mwfigueroa/Electronic_Billboard/foto/panel_p5.png

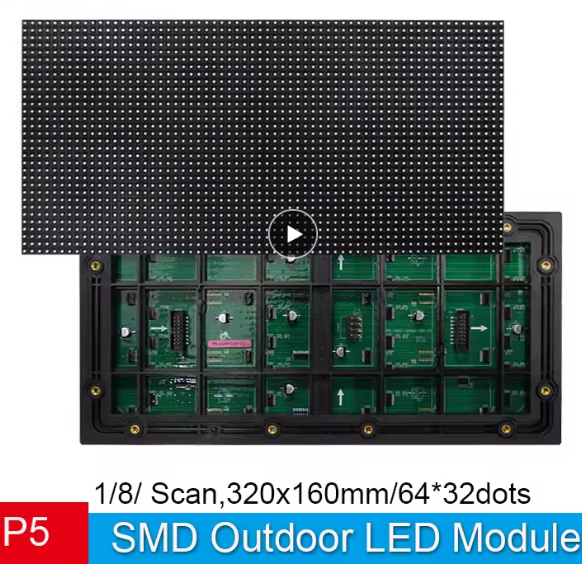
foto/panel_p5.png
