mwfigueroa/Electronic_Billboard/simulator/examples/escena.png

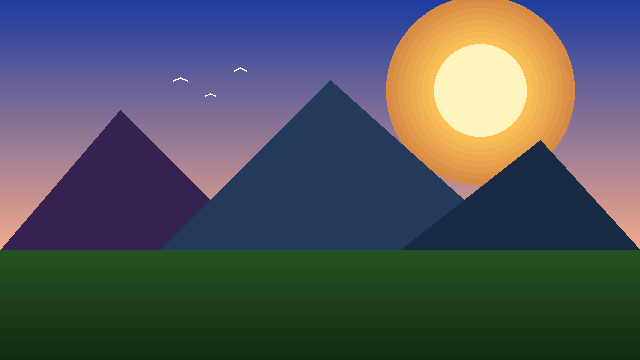
simulator/examples/escena.png
