mwfigueroa/Electronic_Billboard/docs/11_arquitectura_colorlight_5a75b.md

# 11 — Arquitectura del driver sobre Colorlight 5A-75B

Plataforma adoptada en [`10_plataforma_driver.md`](10_plataforma_driver.md). Este documento define la arquitectura del sistema, el punto de operación y el plan de bring-up del driver propio.

> **No sobrescribir el flash de configuración sin respaldo previo.** La 5A-75B arranca desde su SPI flash con el bitstream de fábrica. Volcar esa imagen completa antes de escribir nada.

## La placa

Datos de la **revisión 8.0**, que es la que se compra. Los componentes cambian entre revisiones — ver [`12_referencias_tecnicas.md`](12_referencias_tecnicas.md) para la tabla completa.

| Elemento | Detalle |
|---|---|
| FPGA | Lattice ECP5 **LFE5U-25F-6BG256C**, 24.300 LUT, **1.008 Kbit** de BRAM (EBR) |
| Salidas | **8 conectores HUB75**, 56 salidas bufferadas por 12× 74HC245T a 5 V |
| Memoria externa | SDRAM ESMT **M12L64322A**, 2M × 32 bit, 200 MHz = **8 MB** |
| Red | 2× PHY Gigabit Ethernet Realtek **RTL8211FD** |
| Configuración | SPI flash Winbond **25Q32JVSIQ**, 32 Mbit = 4 MB |
| Reloj | 25 MHz generado por el PHY y distribuido al pin **P6** del FPGA |
| Costo | USD 15–20 |

### Revisión a comprar

La placa tiene variantes con **pinouts y componentes distintos**: 6.1, 7.0, 8.0 y 8.2. No es un detalle menor — cambian el encapsulado del FPGA, la SDRAM, el PHY y todo el mapeo de pines a los conectores HUB75.

**Comprar revisión 8.0 u 8.2.** Son las que `litex-boards` soporta con LiteDRAM, lo que habilita usar la memoria externa sin escribir un controlador propio, y las que tienen el pinout mejor documentado. La 6.1 además usa encapsulado CABGA381 en vez de CABGA256, así que ni siquiera comparte el archivo de restricciones.

Al recibir la placa, identificar la revisión serigrafiada y contrastarla contra [chubby75](https://github.com/q3k/chubby75/tree/master/5a-75b). El pinout completo de la 8.0 y la tabla de diferencias entre revisiones están en [`12_referencias_tecnicas.md`](12_referencias_tecnicas.md).

## Arquitectura del sistema

La 5A-75B es una **placa receptora**: no tiene WiFi, RTC ni almacenamiento de playlist. El sistema completo necesita una capa de contenido por encima.

```mermaid
flowchart TB
    subgraph Contenido["Capa de contenido"]
        CPU["SoC LiteX / VexRiscv<br/>dentro del ECP5<br/>playlist, horarios, NTP"]
        Flash["SPI flash 25Q32<br/>4 MB, bitstream + contenido"]
        Net["PHY Gigabit Ethernet<br/>LiteEth"]
    end

    subgraph FPGA["ECP5-25 — driver de panel"]
        FB["Framebuffer RGB<br/>SDRAM 8 MB"]
        Conv["Conversor RGB → bitplanes"]
        BP["Bitplanes<br/>BRAM interna"]
        Seq["Secuenciador BCM<br/>+ mapeo de scan 1/8"]
        Ser["8 × serializador HUB75"]
    end

    Ext["Router / AP WiFi<br/>o puente ESP32"] -->|"Ethernet"| Net
    Net --> CPU
    Flash --> CPU
    CPU --> FB
    FB --> Conv
    Conv --> BP
    BP --> Seq
    Seq --> Ser
    Ser -->|"J1 … J8"| Panel["16 módulos P5<br/>8 cadenas de 2<br/>256 × 128 px"]
```

### Enlace de contenido

Tres opciones, en orden de preferencia:

1. **SoC LiteX con VexRiscv dentro del propio ECP5** (recomendada). LiteX aporta el softcore RISC-V, LiteEth y LiteDRAM ya integrados para esta placa. La lógica de playlist, horarios y NTP corre en el FPGA; el contenido llega por Ethernet. No hace falta MCU externo. WiFi se resuelve con un AP o puente en el gabinete, que además sirve para mantenimiento.
2. **ESP32 externo por SPI.** Más simple conceptualmente, pero requiere pines libres accesibles en la placa — los buffers de los puertos HUB75 son unidireccionales de salida y no sirven como entrada. Hay que verificar puntos de test disponibles contra chubby75.
3. **ESP32 con MAC Ethernet** (ESP32 clásico con PHY RMII, o ESP32-P4) hablando con LiteEth. Útil si se quiere mantener el ecosistema ESP-IDF para el contenido.

Durante el bring-up **no se necesita ninguna de las tres**: los patrones de prueba se generan dentro del FPGA.

## Topología de paneles

Cambia respecto del diseño original con HD-WF4:

| | HD-WF4 | **5A-75B** |
|---|---|---|
| Cadenas | 4 de 4 módulos | **8 de 2 módulos** |
| Puertos usados | 4 de 4 | 8 de 8 |
| Cables flat | 16 | 16 (sin cambio) |
| Clocks por bitplane (datos) | 8.192 | **2.048** |

Cada fila física del cartel (4 módulos) se divide en **dos cadenas de 2 módulos**, alimentadas por dos puertos contiguos. El cableado de potencia 5 V no cambia: sigue siendo una fuente LRS-350-5 por fila con dos inyecciones de 12 AWG. Ver [`03_electrico.md`](03_electrico.md).

## Presupuesto de memoria

Los 1.008 Kbit de BRAM equivalen a **126 KB**. Un frame de 256 × 128 px ocupa:

| Profundidad | bits/px | Frame | BRAM neta | DP16KD (medido) | Doble buffer |
|---|---:|---:|---:|---:|---|
| 4 bits/color | 12 | 48 KB | 38 % | 24/56 = 43 % | 48 bloques — entra |
| **5 bits/color** | 15 | **60 KB** | **48 %** | **30/56 = 54 %** | 60 bloques — **no entra** |
| 6 bits/color | 18 | 72 KB | 57 % | 32/56 = 57 % | no entra |
| 8 bits/color | 24 | 96 KB | 76 % | 48/56 = 86 % | no entra |

La columna "neta" es la proporción de bits y sirve de cota; la **medida** sale de sintetizar [`driver-5a75b/bitplane_store`](../driver-5a75b/README.md) en el ECP5-25 y es la que manda, porque el primitivo DP16KD es de 18 bits de ancho: 4 y 5 bits por color se redondean al mismo ancho (12 y 15 bits no llenan los 18), 6 bits lo llenan exacto (por eso coincide con la neta) y 8 bits desperdicia un tercio de cada palabra de 36. Con 5 bits quedan 26 bloques libres: alcanza para el contenido, **no** para un segundo framebuffer.

**Diseño adoptado**: los bitplanes viven en BRAM (acceso determinista, sin latencia de SDRAM en el camino crítico del refresco) y los frames RGB más el contenido viven en la SDRAM de 8 MB. El conversor RGB → bitplanes corre solo cuando cambia el contenido, no en cada refresco.

Esto evita el problema que descartó al EP4CE6: el refresco lee de memoria local rápida, y el enlace de contenido solo mueve datos cuando hay un cambio de slide — **~12 KB/s promedio en vez de 12,3 MB/s sostenidos**.

## Punto de operación

Con 8 buses, 2.048 clocks de datos por bitplane. El secuenciador implementado ([`driver-5a75b/bcm_sequencer`](../driver-5a75b/README.md)) agrega 4 clocks de blanking por paso de dirección —necesarios para latchear y asentar la fila con las salidas apagadas—, así que el frame real usa 2.080 clocks por bitplane:

| Profundidad | 12,5 MHz | 16 MHz | 25 MHz |
|---|---:|---:|---:|
| 4 bits/color | 401 Hz | 513 Hz | 801 Hz |
| **5 bits/color** | **194 Hz** | **248 Hz** | 388 Hz |
| 6 bits/color | 95 Hz | 122 Hz | 191 Hz |

**Objetivo inicial: 5 bits/color a 12,5 MHz = 194 Hz** (193,9 Hz medidos en simulación). Cumple el criterio de ≥ 192 Hz con ~1 % de margen; el margen real está en el clock: a 16 MHz sube a 248 Hz. El clock de panel se sube a 16 o 25 MHz solo después de verificar con analizador lógico que no hay ghosting ni pérdida de integridad de señal en los cables flat.

Para cartelería exterior, 5 bits por color (32.768 colores) es suficiente. Subir a 6 bits queda al borde del criterio a 25 MHz (191 Hz con el blanking actual; con `BLANK_CLOCKS=2` llegaría a ~192 Hz), así que si el contenido lo justifica conviene validarlo en banco antes de fijarlo.

## Bloques HDL

| Bloque | Responsabilidad |
|---|---|
| `hub75_serializer` (×8) | Desplaza RGB, genera `CLK` por puerto. Idéntico ocho veces, instanciado en paralelo. |
| `bcm_sequencer` | Secuencia de bitplanes, ancho de pulso de `OE`, blanking de `LAT`, avance de dirección `A`/`B`/`C`. Uno solo: gobierna los ocho serializadores en lockstep. |
| `scan_mapper` | Traduce `(x, y)` del framebuffer a `(paso de dirección, posición en cadena, grupo)`. **Específico del panel — es la incógnita principal.** |
| `bitplane_store` | BRAM de bitplanes, doble puerto: escritura del conversor, lectura del secuenciador. |
| `rgb_to_bitplane` | Conversión de frame RGB a planos de bits, con corrección de gamma. Corre en cambios de contenido. |
| `LiteDRAM` | Controlador de SDRAM. Provisto por LiteX en revisiones 8.0/8.2. |
| `LiteEth` | MAC + UDP/Etherbone. Provisto por LiteX. |

Los ocho serializadores comparten direcciones, `LAT` y `OE` — igual que la HD-WF4 compartía esas señales entre bancos. La diferencia es que acá los ocho transmiten **simultáneamente**, no alternados, porque cada uno tiene sus propios pines RGB.

## Toolchain

Todo abierto, sin licencias:

| Herramienta | Función |
|---|---|
| **Yosys** | Síntesis Verilog |
| **nextpnr-ecp5** | Place & route |
| **Project Trellis** | Generación de bitstream |
| **openFPGALoader** | Carga por JTAG y escritura de la SPI flash |
| **LiteX** + `litex-boards` | SoC, LiteEth, LiteDRAM, plataforma `colorlight_5a_75b` |
| **Verilator** / **cocotb** | Simulación y testbench |

Recomendado: instalar vía [oss-cad-suite](https://github.com/YosysHQ/oss-cad-suite-build), que trae todo empaquetado. Sobre Windows funciona bien bajo WSL2.

## Plan de bring-up

### Paso 0 — Identificar y respaldar

- [ ] Fotografiar ambos lados, anotar revisión serigrafiada y contrastar con chubby75.
- [ ] Verificar que sea revisión 8.0 u 8.2; si no, ajustar el archivo de plataforma de LiteX al pinout real.
- [ ] Volcar la SPI flash completa (4 MB en rev 8.0) antes de escribir nada.
- [ ] Instalar oss-cad-suite y cargar un bitstream de blink por JTAG (sin tocar la flash) para validar el flujo.

### Paso 1 — Un módulo, un puerto, sin BCM

- [ ] Instanciar un solo `hub75_serializer` en `J1` con 1 bit por color.
- [ ] Mostrar rojo, verde, azul, blanco, negro y una grilla.
- [ ] Medir `CLK`, `LAT`, `OE` y `A`/`B`/`C` con analizador lógico.
- [ ] Confirmar niveles de salida de los level shifters de la placa.

### Paso 2 — Descubrir el mapeo de scan

- [ ] Si el vendedor entregó archivo de configuración, derivar el mapeo de ahí.
- [ ] Si no: encender un único píxel en la posición *k* de la cadena, fotografiar dónde aparece, e iterar sobre las 128 posiciones × 8 direcciones.
- [ ] Volcar el resultado en una tabla de lookup y codificarla en `scan_mapper`.
- [ ] **Este paso condiciona todo lo demás. No avanzar sin cerrarlo.**

### Paso 3 — BCM y profundidad de color

- [ ] Agregar `bcm_sequencer` con 4 bits por color en un puerto.
- [ ] Ajustar blanking de `LAT` y duración de `OE` hasta eliminar ghosting.
- [ ] Verificar refresco medido contra el calculado.
- [ ] Subir a 5 bits y confirmar linealidad con corrección de gamma.

### Paso 4 — Ocho puertos

- [ ] Instanciar los 8 serializadores con contenido distinto por cadena.
- [ ] Conectar las 8 cadenas de 2 módulos y verificar el mapeo 256 × 128 con patrón numerado.
- [ ] Confirmar que no haya cruce entre cadenas ni deriva de temporización.

### Paso 5 — Contenido y red

- [ ] Integrar LiteDRAM y mover el framebuffer RGB a SDRAM.
- [ ] Integrar LiteEth y el SoC LiteX.
- [ ] Playlist, reloj, NTP, brillo y actualización remota.

### Paso 6 — Estrés

- [ ] 24 h a patrón blanco en banco, con las mediciones de [`03_electrico.md`](03_electrico.md).

## Criterios de aceptación

Reemplazan a los de [`09_firmware_propio_hd_wf4.md`](09_firmware_propio_hd_wf4.md):

- Los ocho puertos muestran contenido distinto en su cadena correspondiente.
- No hay filas cruzadas, ghosting, colores alterados ni parpadeo visible a la distancia de uso.
- **Refresco efectivo ≥ 192 Hz a brillo operativo con 5 bits por color.**
- Las transiciones de dirección y latch mantienen `OE` deshabilitado.
- La alimentación de la matriz cumple las mediciones de [`03_electrico.md`](03_electrico.md).
- El bitstream de fábrica está respaldado y el procedimiento de restauración verificado.
- El contenido se actualiza por red sin reprogramar el FPGA.

## Riesgos y límites

- **Variación de revisión de placa.** Los pinouts difieren entre 6.1, 7.0, 8.0 y 8.2. Comprar sin especificar revisión es comprar un pinout desconocido.
- **IC driver del panel sin confirmar.** Si el módulo usa S-PWM interno (MBI5153, FM6353), el modelo BCM de este documento no aplica y el protocolo es otro. Ver [`08_hub75e_y_panel_p5.md`](08_hub75e_y_panel_p5.md).
- **Mapeo de scan desconocido.** Es el riesgo de cronograma más grande del driver. Se mitiga consiguiendo el archivo de configuración del vendedor.
- **Los level shifters son 74HC245T**, no AHCT. Alimentados a 5 V, el umbral de entrada alto de la familia HC ronda 0,7 × VCC ≈ 3,5 V, por encima de los 3,3 V que entrega el FPGA. En la práctica estas placas funcionan —es su diseño de fábrica— pero el margen es escaso y puede degradarse con temperatura. Si aparecen bits inestables a clock alto, este es el primer sospechoso. Ver [`12_referencias_tecnicas.md`](12_referencias_tecnicas.md).
- **Sin RTC ni WiFi en placa.** El reloj sale de NTP y la conectividad de un AP externo en el gabinete.
- **Verilog es otra disciplina.** El proyecto pasa de depurar un sistema a depurar tres: HDL, capa de contenido y el enlace entre ambos.

## Fuentes

- [chubby75 — 5A-75B](https://github.com/q3k/chubby75/tree/master/5a-75b) — esquemáticos, pinouts por revisión
- [YosysHQ: Introducing the Colorlight 5A-75B](https://blog.yosyshq.com/p/colorlight-part-1/)
- [litex-boards: plataforma `colorlight_5a_75b`](https://github.com/litex-hub/litex-boards/blob/master/litex_boards/platforms/colorlight_5a_75b.py)
- [litex-boards: target `colorlight_5a_75x`](https://github.com/litex-hub/litex-boards/blob/master/litex_boards/targets/colorlight_5a_75x.py)
- [Lattice ECP5 / ECP5-5G](https://www.latticesemi.com/en/Products/FPGAandCPLD/ECP5)
- [oss-cad-suite](https://github.com/YosysHQ/oss-cad-suite-build)
