mwfigueroa/Electronic_Billboard/hardware/cad/requirements-pdf.txt

# Render de la ficha HTML a PDF, independiente del Python de FreeCAD.
weasyprint==70.0
