mwfigueroa/Electronic_Billboard/foto/estructura_basica.jpeg

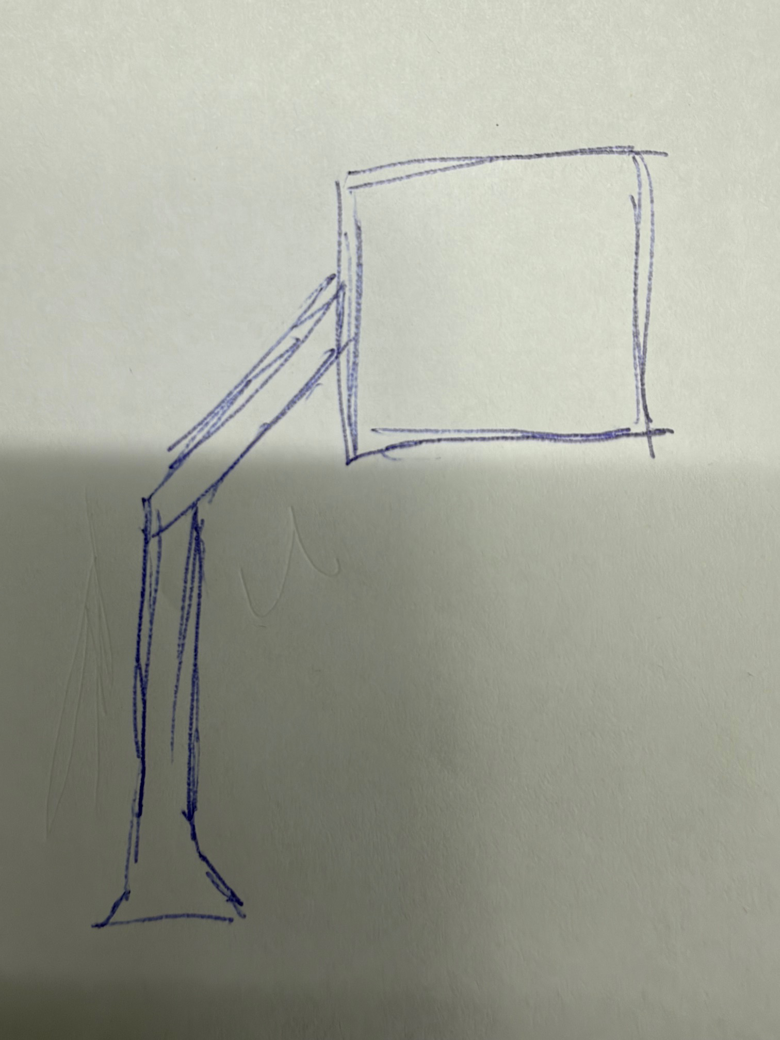
foto/estructura_basica.jpeg
