mwfigueroa/Electronic_Billboard/foto/Estructura_Cartel.png

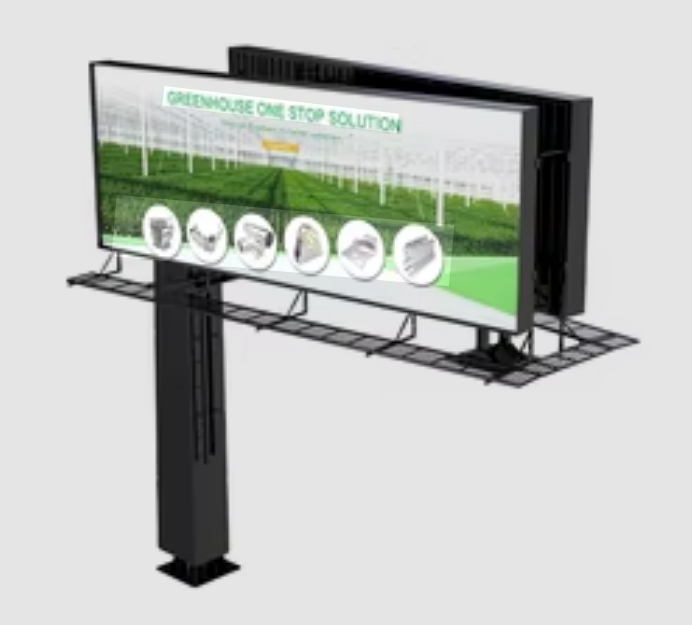
foto/Estructura_Cartel.png
