mwfigueroa/Electronic_Billboard/(commit log)

2026-08-31 docs: proyecto cartel LED exterior 50" — especificaciones, BOM, eléctrico, estructura, fases y contenido
2026-09-14 docs: revisión a 56" con panel LYERAEEN P5 y arquitectura de control
    Actualiza el proyecto desde el diseño original de 50" al panel realmente
    seleccionado (LYERAEEN P5-320x160-8S-1921, 16 módulos en 4x4, 256x128 px)
    y suma la documentación de arquitectura funcional y de interfaz.
    - README y 01-06: dimensiones, consumo, BOM, cableado y fases recalculados
    sobre el panel real. El módulo declara >4500 nits, no los 5000 del
    objetivo inicial, y su IP y refresco siguen sin confirmar.
    - 07: diagrama de bloques funcional de potencia y control.
    - 08: señales HUB75E, ficha de compra del panel y particularidad de los
    dos bancos de salida de la HD-WF4.
    - 09: análisis del firmware ESP-IDF pr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
2026-09-14 docs: adoptar Colorlight 5A-75B como plataforma del driver propio
    Evalúa cuatro plataformas para el control directo de la matriz y adopta
    la Colorlight 5A-75B (FPGA Lattice ECP5-25, toolchain abierto).
    El cuello de botella no es la velocidad del procesador sino cuántos buses
    RGB pueden manejarse en simultáneo y dónde vive el framebuffer:
    - HD-WF4: dos buses con bancos serializados por GPIO45/GPIO14, y el
    LCD_CAM del ESP32-S3 saca 16 bits por clock donde hacen falta 17.
    Piso de 8192 clocks/bitplane; 5 bits/color y 192 Hz son objetivos
    mutuamente inalcanzables.
    - ESP32-P4 con etapa propia: 4 buses reales, pero la FireBeetle 2 no
    expone los 30 GPIO necesarios y hay que diseñar la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
2026-09-14 docs: referencias técnicas de la 5A-75B, ECP5 y BOM de desarrollo
    Consolida la documentación técnica necesaria para escribir HDL y define
    el hardware de banco mínimo.
    - 12: revisiones de placa y sus diferencias, pinout completo de la V8.0
    con ejemplo de .lpf, datasheet y notas técnicas del ECP5, datasheets de
    los componentes de placa, entorno de desarrollo e instalación, flujo de
    build, opciones de programador JTAG y referencias de la comunidad.
    - 13: BOM de desarrollo en cuatro niveles comprables por separado, cada
    uno atado a un paso del plan de bring-up.
    Correcciones a 10 y 11 a partir de los datos verificados de la revisión
    8.0, que difieren de la descripción general de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
2026-09-14 docs: familias de IC driver de panel y modelo del software de contenido
    - 12: nueva sección con las tres familias de IC driver (desplazamiento
    simple, desplazamiento con configuración, S-PWM con memoria interna),
    su impacto sobre el proyecto y cómo determinarlas. Los más de 50 part
    numbers en circulación colapsan en tres comportamientos, y solo la
    familia define la arquitectura del driver.
    La conclusión accionable es que el modelo de IC se puede exigir al
    comprar en vez de descubrirlo después: especificar ICN2038S o FM6126A
    elimina el mayor riesgo de cronograma del driver sin sobreprecio.
    - 14: modelo del software de contenido. Reparto PC/cartel bajo el
    principio de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
2026-09-14 docs: notas técnicas, observaciones de diseño y bitácora de bring-up
    Crea un lugar para lo que no es especificación: consecuencias del
    análisis y el registro de hallazgos con el hardware real. El track del
    driver no tenía equivalente al registro de incidencias del doc 05.
    Observaciones nuevas, no documentadas hasta ahora:
    - El recurso ajustado del ECP5-25 es la BRAM, no las LUTs. Al optimizar
    no tiene sentido pelear por lógica; se recorta profundidad de color o
    se empuja el framebuffer a SDRAM.
    - 12,5 y 25 MHz son los clocks "gratis": el oscilador de entrada es de
    25 MHz, así que salen por división directa. Los 16 MHz de las tablas
    de refresco son el punto incómodo, porqu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
2026-09-15 chore: ignorar el directorio logs/
    Los logs de herramientas (MCP, depuradores) no son parte del proyecto.
2026-09-15 docs: registrar la instalación de OSS CAD Suite
    Reemplaza la cadena FPGA de los repos de Ubuntu (Yosys 0.33, nextpnr 0.6)
    por la distribución binaria de YosysHQ, build 20260915: Yosys 0.69,
    nextpnr 0.11.1, Verilator 5.053, Icarus 14.0, GHDL 7.0-dev con plugin de
    Yosys y openFPGALoader 1.1.1, más SymbiYosys y los solvers SMT.
    TOOLCHAIN.md documenta la instalación, qué paquetes se purgaron, por qué
    las herramientas se exponen con wrappers en ~/.local/bin en vez de
    symlinks o de sourcear el environment en el .bashrc, y el estado de los
    pendientes de hardware (grupo dialout y reglas udev, ya resueltos).
2026-09-15 test(fpga): blinky de validación del toolchain para iCEstick
    Proyecto mínimo iCE40HX1K-TQ144 que ejercita el flujo completo
    synth_ice40 -> nextpnr-ice40 -> icepack, más simulación, lint y timing.
    Sirve para revalidar el toolchain tras cada actualización de la suite.
    D5 parpadea a 1 Hz y D1..D4 rotan a la misma cadencia. El top está
    parametrizado en CLK_HZ/BLINK_HZ para que el testbench simule en
    microsegundos en vez de esperar millones de ciclos.
    make all sim lint timing stats pasan: 83 celdas, 201 MHz contra los
    12 MHz de la restricción, camino crítico de 6.48 ns.
2026-09-15 feat(fpga): blinky de bring-up Paso 0 para Colorlight 5A-75B
    Implementa el Paso 0 de docs/11_arquitectura_colorlight_5a75b.md: cargar
    un bitstream de parpadeo por JTAG, sin tocar la SPI flash, para validar
    el flujo synth_ecp5 -> nextpnr-ecp5 -> ecppack -> openFPGALoader sobre
    la placa real.
    Además resuelve el pendiente de la sección 7 de
    docs/12_referencias_tecnicas.md: el pin del LED de usuario está en
    disputa entre fuentes (T6 según chubby75, P11 según weigu). El diseño
    maneja los dos pines a frecuencias distintas —1 Hz y 4 Hz— así que una
    sola carga identifica cuál es el LED por su cadencia. El botón R7 fuerza
    ambas salidas a 0, lo que además determina la polaridad.
    No hay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
2026-09-15 chore: fijar finales de línea LF con .gitattributes
    El proyecto vive en /mnt/p (drvfs) y se edita indistintamente desde
    Windows y desde WSL, así que cualquier editor de Windows reescribía los
    .md con CRLF y git los reportaba como modificados de punta a punta.
    `* text=auto eol=lf` normaliza al entrar al índice y al hacer checkout.
    Se agregan reglas `binary` para imágenes, PDF, modelos 3D y artefactos
    de FPGA, para que git no intente normalizarlos ni diffearlos.
    Verificado: git check-attr aplica eol=lf sobre docs y RTL, un archivo con
    CRLF entra al índice sin CR, y `git add --renormalize .` no cambia nada
    —el árbol ya estaba en LF tras la limpieza previa—.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
2026-09-15 feat(simulador): pipeline de contenido, visor LED y vectores para el HDL
    Implementa el nucleo de docs/14_software_contenido.md: playlist declarativa
    -> composicion a canvas RGB888 256x128 -> gamma y cuantizacion a 4/5/6 bits
    -> bitplanes, que es la referencia de oro del HDL. Tres salidas comparten el
    mismo pipeline: PNG por slide, visor pygame en tiempo real y vectores .mem
    para los testbenches (con manifest de layout explicito).
    Decisiones y verificaciones:
    - Dos gammas separadas: quantize lleva el valor al duty del panel
    (duty = (v/255)**gamma; 2.2 reproduce sRGB) y to_display re-codifica con
    la respuesta fija del monitor (1/2.2). Sin ese re-codificado el preview
    salia mas oscuro qu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
2026-09-15 docs: cadena completa fuente->display de la ruta 5A-75B (16)
    Agrega docs/16_cadena_completa.md como vista de integración del driver
    propio: diagrama de datos (PC -> red -> PHY/LiteEth/SoC/SDRAM ->
    rgb_to_bitplane -> bitplane_store -> bcm_sequencer + scan_mapper ->
    serializadores -> 74HC245T -> 8 cadenas de 2 módulos P5), diagrama de
    potencia (idéntico a la ruta de producción, según docs/07), tabla de
    señales y correspondencia con los números ya validados en el simulador.
    Enlaces cruzados, sin duplicar datos: docs/07 apunta al 16, docs/12 §9
    también, el árbol del README raíz lo lista y docs/14 pasa a estado
    "núcleo implementado" con enlace al simulador.
2026-09-15 chore: foto de referencia del panel P5 para la calibración de la máscara
    Foto representativa del módulo P5 outdoor, usada para medir el gap de la
    máscara LED (~1/3 del paso) y para la comparación lado a lado que quedó
    en simulator/out/led_shape.png. Material del anuncio del proveedor, solo
    referencia de diseño.
2026-09-15 chore: pre-commit que corre la suite del simulador
    Red de seguridad contra commits que dejan tests fijando valores viejos:
    si el commit toca simulator/, el hook corre `make -C simulator test`.
    Sin venv aborta con instrucciones; `--no-verify` queda para commits que
    no tocan código. Se activa con `make hooks` (git config core.hooksPath
    .githooks).
2026-09-15 fix(simulador): cierra la revisión externa (máscara fiel, video y captura)
    Los nueve hallazgos de la revisión:
    - docs/16: la gamma estaba aplicada dos veces (PC y FPGA). El bloque del
    FPGA queda como "conversión a bitplanes, ubicación según contrato de
    wire" y la tabla aclara que la gamma vive en un solo lado. Además A/B/C
    llevan el paso de dirección 1/8 (D/E sin uso) y el bus interno es
    Wishbone (default de litex-boards), no AXI.
    - Máscara fiel: con celda < 5 px no se dibuja — a celda 3 el LED queda
    con el triple del área real (37 % contra el ~12 % medido en la foto) —
    y el default pasa a --scale 5 (celda 5: 12,6 %). El panel se ajusta a
    celdas enteras cuando ha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
2026-09-15 fix(simulador): cierre limpio del visor con SIGTERM/SIGINT
    SDL captura las señales pero no siempre termina el loop: el proceso quedaba
    vivo tras `kill` (hubo que usar KILL). El visor instala sus propios handlers
    después de inicializar pygame y sale limpio. Verificado en headless y en la
    ventana real.
2026-09-15 feat(hdl): rgb_to_bitplane validado contra los vectores dorados
    Primer bloque del driver (docs/11); con esto la duplicación deliberada de
    docs/14 queda verificada: el HDL coincide bit a bit con panel_sim.quantize.
    - driver-5a75b/: rgb_to_bitplane (RGB888 -> 3*DEPTH planos, empaquetado
    [bit*3+canal], un registro de salida), testbench que carga el frame de
    entrada y los planos esperados desde ../simulator/vectors, y Makefile
    con sim/lint/synth/stats/vectors. Simulación: 128 píxeles x 15 bits =
    1920 comparaciones, 0 fallas. Síntesis: 167 LUT4 + 16 FF en ECP5.
    - La gamma y la cuantización van por LUT de 256 entradas generada con
    quantize(), así el redondeo coincide con el softwa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
2026-09-15 chore(hdl): ignorar artefactos de build del driver
    Mismo patrón que los blinky (build/, *.vcd). Se saca del índice el .vvp que
    se había colado en el commit anterior.
2026-09-15 feat(hdl): secuenciador BCM y serializador HUB75 con testbench de temporizacion
    Completa el camino de refresco validable sin placa:
    - bcm_sequencer: maestro del frame. Paso de direccion de 256 clocks de
    shift + 4 de blanking; los datos de la fila `row` se desplazan mientras
    el panel muestra los de `row-1` (shift-while-display) y la direccion
    cambia dentro del blanking. El bitplane k se muestra 2^k pasadas (peso
    BCM): un frame son (2^DEPTH-1) x 8 x (SHIFT+BLANK) = 64.480 clocks a
    5 bits, o sea 193,9 Hz a 12,5 MHz, por encima del criterio de 192 Hz.
    - hub75_serializer: registra los 6 bits de la cadena y saca CLK invertido
    y gateado por shift_en, para que el blanking no corra la po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
2026-09-15 chore: el pre-commit tambien corre los testbenches del driver
    Si el commit toca driver-5a75b/, el hook corre `make -C driver-5a75b sim`
    ademas de la suite del simulador cuando toca simulator/. Documentado en el
    README del simulador y en el arbol del README raiz.
2026-09-15 feat(hdl): bitplane_store con escritura y lectura validadas contra vectores
    Memoria simple dual-port: escribe el conversor, lee el futuro scan_mapper.
    Palabra de 3*DEPTH bits por pixel empaquetada [bit*3 + canal], direccion
    lineal y*WIDTH + x.
    - tb_bitplane_store encadena conversor -> store -> lectura al reves y
    compara contra los planos reconstruidos de los vectores: 128 palabras,
    0 fallas.
    - Sintesis (256x128, 5 bits): 30 bloques DP16KD de 56 = 54 %. Queda
    documentado que el primitivo de 18 bits hace que 4 y 5 bits por color
    redondeen al mismo ancho y que con 5 bits no entra un doble buffer.
    - Queda anotada la decision abierta del lado de lectura (una palabra por
    clock; el frent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
2026-09-15 docs: numeros medidos de BRAM y refresco en docs y simulador
    Las tablas de docs/11 quedaban contradiciendo la nota de sintesis y otras
    copias repetian el modelo ideal:
    - Presupuesto de memoria: columna medida (4/5/6/8 bits = 24/30/32/48 de 56
    bloques DP16KD = 43/54/57/86 %) y verificacion del doble buffer: con 5
    bits no entra (60 bloques), con 4 si (48). Se explica la granularidad de
    18 bits del primitivo.
    - Punto de operacion: 2080 clocks por bitplane (2048 de datos + blanking)
    -> 401/194/95 Hz a 12,5 MHz. 5 bits queda con ~1 % de margen sobre el
    criterio; 6 bits a 25 MHz al borde (191 Hz).
    - Propagado a docs/10, docs/16, README raiz y al modelo del simulador
    (timing.py 2048 ->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
2026-09-16 feat(hdl): top de integracion, .lpf completo y polaridad de OE verificada
    Cierra el camino que se puede validar sin placa:
    - rtl/top.v: generador de patron -> rgb_to_bitplane -> bitplane_store ->
    bcm_sequencer -> 8 x hub75_serializer, con latido de frame en los dos
    candidatos a LED de usuario (T6/P11). Placeholder documentado en el
    mapeo de lectura (y = row, x = pix): el real es del scan_mapper.
    - constraints/colorlight_5a75b_v8.lpf: 60 pines desde docs/12 §2 (54 de
    HUB75 + 2 LED + clock + boton), con la aclaracion de nombres R0/R1 de
    chubby75 vs R1/R2 de HUB75.
    - sim/tb_top.v: verificacion de integracion. Encontro un off-by-one real
    (una escritura extra al store al salir del r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
2026-09-16 docs: polaridad de OE del panel (activo bajo) en 08, 11 y 16
    El OE de HUB75 no estaba declarado en ningun documento y docs/11 lo
    describia al reves al hablar del blanking ("OE en bajo"), que para un pin
    activo bajo significa fila encendida. docs/08 ahora fija la polaridad
    (0 enciende, 1 apaga), docs/11 corrige la frase y docs/16 la referencia.
2026-09-16 feat(simulador): fuente viva y contrato de wire v1 (MJPEG, UDP, X11)
    Permite desarrollar el software de alto nivel contra el panel virtual sin
    inventar protocolo: la app manda frames RGB888 de 256x128 y el panel hace el
    resto (gamma, cuantizacion, bitplanes, mascara).
    - Slide `live` en la playlist: url de ffmpeg, fps y, segun el transporte,
    format/pixel_format/size. Descarta atrasos (sigue el ultimo cuadro) y
    reintenta la conexion cada 2 s si el stream se corta.
    - Canales: MJPEG/HTTP (autodetectado), rawvideo sobre UDP y x11grab/v4l2.
    La baja latencia (nobuffer) solo se aplica donde no rompe: con rawvideo
    descarta el unico cuadro de un archivo (verificado).
    - examples/app_ejemplo.py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
2026-09-16 docs: contrato de wire v1 y reparto PC/panel coherente
    El contrato v1 quedo decidido (la PC manda RGB888; gamma, cuantizacion y
    bitplanes viven en el panel), pero el documento se contradecia consigo
    mismo: la tabla de reparto asignaba gamma y cuantizacion a la PC, el
    diagrama del pipeline las ubicaba antes del wire y docs/16 dejaba la
    conversion como "ubicacion segun contrato".
    - docs/14: fila de reparto invertida, principio rector ajustado (la PC
    manda pixeles, no frames cuantizados) y diagrama del pipeline con la
    frontera PC <-> panel marcada.
    - docs/16: la PC manda frames RGB888, el bloque del FPGA vuelve a
    rgb_to_bitplane con gamma y cuantizacion, y el condicionante del
    contrato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
2026-09-16 docs(16): vista de sistema completa con el estado de cada tramo
    Agrega arriba del diagrama de datos un mapa de todo el sistema: contenido,
    contrato v1, control (las dos rutas), panel y potencia, con el espejo virtual
    del banco de desarrollo, y una tabla de estado por tramo con su dependencia.
2026-09-16 feat(simulador): separa content/ del panel y agrega la app con horarios
    El paquete se parte por la frontera del contrato de wire v1: content/
    (playlist, canvas, timeline, video) termina en frames RGB888 de 256x128 y no
    sabe nada de LED; panel_sim/ (gamma, bitplanes, timing, visor, vectores)
    empieza ahi. El corte es estructural, no una convencion.
    - Horarios por slide: desde/hasta (HH:MM, con ventana nocturna) y dias.
    El Timeline filtra, salta inactivos y publica negro si no queda programa.
    - content/app.py: la app de referencia; Timeline + publicador MJPEG, con
    recarga en caliente (conserva la playlist anterior si la nueva es
    invalida) y /status para supervision (frames, errores, slid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
2026-09-16 chore: ignorar .mypy_cache y .ruff_cache
    El cache de mypy en la raiz son 705 archivos y 51 MB; sin la regla entraba
    al proximo commit. ruff por adelantado.
2026-09-16 docs: estado del software con la app, horarios y el split
    - docs/14: el estado apunta a los dos paquetes (content/ y panel_sim/) y a
    la app de publicacion.
    - README raiz: el arbol del simulador lista content/, panel_sim/ y los
    comandos nuevos (app y demo).
2026-09-16 feat(simulador): editor de playlist con preview en vivo
    Herramienta del lado panel (como el visor): servidor local sin dependencias
    que lista y edita los slides, valida en memoria, previsualiza el pipeline
    real (gamma + cuantizacion a la profundidad de la playlist) por MJPEG y
    guarda el archivo validado.
    - editor.py + editor.html: agregar/mover/borrar slides, subir imagenes a
    imagenes/, preview del ciclo completo o de un slide puntual, y barra de
    estado con error y "sin guardar".
    - Un documento invalido se adopta para poder seguir editando, pero se
    conserva el ultimo timeline valido para el preview; save() no escribe si
    hay error.
    - content.playlist.parse(): separado de load() para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
2026-09-16 docs: el editor minimo cumple lo que pedia 14 para la UI
    La nota de "que no hacer todavia" pedia que, si aparecia una UI, fuera un
    editor del archivo con preview del simulador. El editor minimo ya existe
    (panel_sim/editor.py) y hace eso, asi que queda registrado.
2026-09-16 feat(simulador): vinculo directo app -> panel por socket Unix
    Con app y panel en la misma maquina, la app publica ademas los cuadros
    RGB888 crudos en un socket Unix (/tmp/billboard.sock por defecto): el panel
    los consume bit a bit, sin codec ni ffmpeg. Es el camino de mayor fidelidad
    (permite comparar contra el JPEG del stream) y el mas barato en CPU.
    - rawlink.py: RawSocketServer (lado app; encabezado BILLBOARD/1 RAW y
    cuadros de w*h*3 bytes, siempre el ultimo) y RawSocketSource (lado panel,
    con reconexion cada 2 s y reencuadre si se atrasa, como el resto de las
    fuentes vivas). El listener usa timeout para que close() no espere a una
    conexion que no llega.
    - El slide live acepta ur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
2026-09-16 contenido: primer slide personalizado del ejemplo
    Edicion hecha desde el editor con preview: texto, tamano y color del primer
    slide. Verifica el circuito completo (editor -> archivo -> recarga en
    caliente de la app -> panel).
2026-09-17 docs(16): vista de sistema con el contrato y el camino del FPGA desplegado
    El diagrama tenía el contrato de wire como etiqueta de una flecha y todo el
    driver metido en una sola caja "Camino". Ahora:
    - el contrato es un nodo propio, así se ve que la app y el panel virtual
    cuelgan de él y que HD2020 no lo cruza;
    - el camino del FPGA queda abierto en sus bloques reales, con lo que el
    scan_mapper se ve como el hueco en medio de la cadena de refresco;
    - las aristas llevan el mecanismo y no solo la conexión: ~12 KB/s solo al
    cambiar de slide contra la lectura del refresco desde BRAM, que es lo que
    justifica la plataforma;
    - aparece vectores dorados -> valida el HDL, la relación que s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
2026-09-17 feat(simulador): clips de ejemplo generados (pauta publicitaria y placa de IA)
    Dos placas de 10 s a 256×128 para ejercitar el slide `video` y, de paso, la
    fidelidad del vínculo directo, que las muestra sin códec de por medio:
    - `pauta`: tanda publicitaria en tres escenas con zoom, entrada lateral,
    parpadeo y una marquesina corriendo abajo.
    - `ia`: red neuronal con pulsos viajando por las sinapsis.
    Se dibujan con Pillow y son deterministas respecto de `t`; ffmpeg solo
    codifica. No hay descarga de red: `make clips` los genera de cero, a
    diferencia de `make video`, que baja Sintel.
    Los mp4 van al repo porque son 600 KB y sirven como contenido de ejemplo
    reproducible; `.gitattributes` lo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
2026-09-17 feat(simulador): el editor sube videos y el preview no se corta si falta el archivo
    Con los clips de ejemplo el editor tenía dos agujeros:
    - subía todo a `imagenes/`. Ahora enruta por extensión: mp4, webm, mov, m4v,
    mkv y avi van a `videos/`, el resto a `imagenes/`, y el selector filtra por
    tipo según el slide. Un fallo de subida además se avisa en vez de quedar en
    silencio.
    - una ruta que no existía levantaba la excepción dentro del stream MJPEG y
    cortaba el preview entero. Ahora se dibuja un placeholder "FALTA ARCHIVO"
    y el motivo se imprime una vez por mensaje. Es el caso normal al agregar un
    slide de video: el skeleton ya no trae `path`, justamente para que pida el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
2026-09-21 docs: gabinete R2, mástil con brazo R2.1, costos y coherencia de 01–05
    El cartel deja la fachada: es el gabinete LED (display 1.280×640 + borde de
    30 mm) en voladizo sobre un mástil 120×120×6,35 con brazo 120×120×4,75 a 45°,
    altura libre 2,50 m (⚠ ordenanza) y zapata 1,6×1,6×0,6 (⚠ suelo).
    - 17: gabinete R2 (fondo 230, bastidor de acero, marco que rodea los LED sin
    taparlos, junta EPDM en el retorno, drenajes, capotas, puertas con bisagra).
    - 18: soporte R2.1 (mástil sin registro, brida doble atornillada, placas de
    anclaje, reserva de conducto en la zapata, verificaciones automáticas);
    se retiran las afirmaciones de utilización y FS fijos.
    - 19: estimación de costo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
2026-09-21 feat(cad): modelo paramétrico del mástil con brazo, verificaciones y fichas
    hardware/cad/ es la fuente de verdad de las cotas de docs/17 y 18:
    - monoposte.py: fundación, mástil, brazo con brida doble y el gabinete LED con
    su estructura interna, en FreeCAD (Part). Un parámetro por cota; LADO_MASTIL
    espeja el conjunto. Aborta la exportación si hay interferencias.
    - verificar_modelo.py: validez de sólidos, interferencias entre todas las
    parejas (solo se admiten embebidos declarados contra hormigón), barrido de
    apertura de puertas y sondas en los pasos de cable.
    - vistas.py: regenera el modelo con colores y siete vistas PNG; medir.py
    contrasta el FCStd guardado con lo que prom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
2026-09-21 fix(simulador): el visor sobrevive a WSLg — handshake X11, audio dummy y make live
    Tres cuelgues del visor, todos del entorno y no del pipeline:
    - Un DISPLAY viejo (export de VcXsrv en .bashrc) apuntaba a un puerto que
    acepta el TCP y nunca contesta; el chequeo era un connect pelado. Ahora se
    manda el pedido de conexión X11 y, si no hay respuesta, cae a :0 con aviso.
    - pygame.init() se bloqueaba en el init de audio de SDL sobre el Pulse/ALSA de
    WSLg; el visor no emite sonido: SDL_AUDIODRIVER=dummy por defecto.
    - La detección de WSL dependía de WSL_DISTRO_NAME/WSL_INTEROP, que una shell
    recortada no trae; ahora también mira /proc/version y /mnt/wslg.
    make live levanta app + vi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
